yolisses/lispm/README.md

# LiSPM

_DIY low cost open source scanning probe microscope_

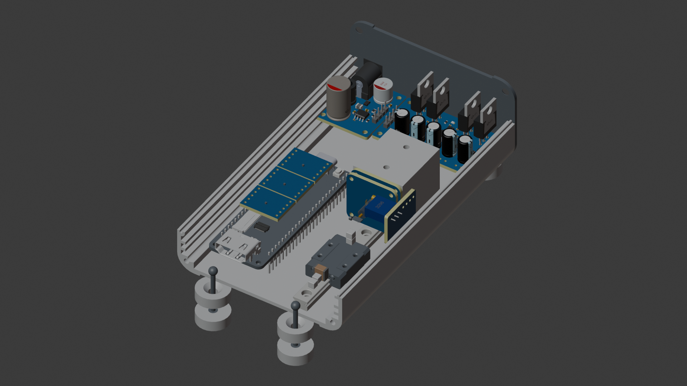
[picture p1: assets/3D Model.png]
3D model of the LiSPM


LiSPM aims to be a low cost scanning probe microscope (SPM), that works both as scanning tunneling microscope (STM) and atomic force microscope (AFM)

[More info on Docs](https://lispm.site)
