yolisses/lispm/Mechanics/README.md

# Piezo Support

The piezo support holds the scanning piezo disk aligned to the coarse actuator linear slider.

## Features

- Snap fit to the rail
- Screw holes to the rail
- Screw holes to the capacitive displacement sensor (CDS)
