yolisses/lispm/Electronics/README.md

# Electronics

The KiCAD projects here are just for simulation.

The printed circuit, passive parts selection and so on were moved to EasyEDA for closer integration with the manufacturer.
