yolisses/lispm/docs/index.md

---
title: LiSPM
layout: home
nav_order: 1
---

# LiSPM

3D model of the LiSPM

LiSPM is an open-source Scanning Probe Microscope (SPM). It can operate as a Scanning Tunneling Microscope (STM), an Atomic Force Microscope (AFM), or both simultaneously. It uses audio DACs and ADCs to reduce costs and achieve better precision than some previous works.
