yolisses/lispm/Documentation/content/Appendices/Resolution demo.md

# Resolution demo

Here are some images to give a sense of bandwidth:

## 250x250

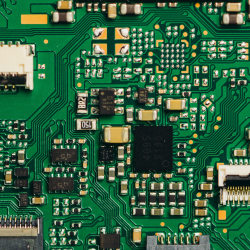
[picture p2: Documentation/static/resolution-demo-250x250.png]
Circuit on 250 by 250 pixels


## 500x500

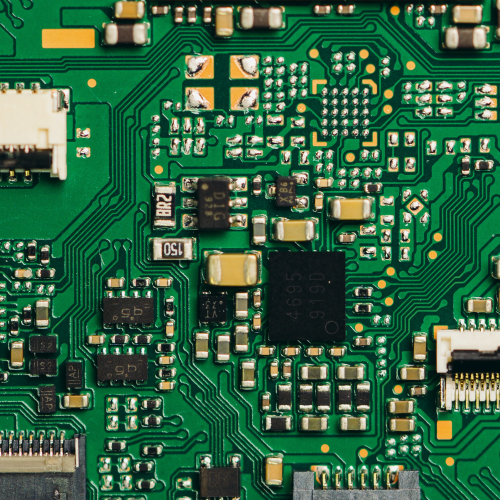
[picture p3: Documentation/static/resolution-demo-500x500.png]
Circuit on 500 by 500 pixels


## 1000x1000

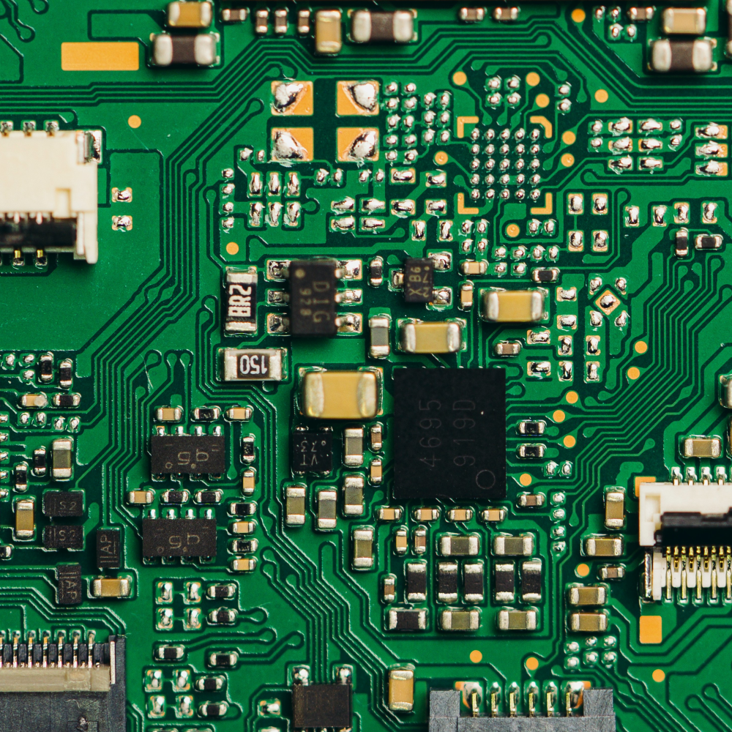
[picture p4: Documentation/static/resolution-demo-1000x1000.png]
Circuit on 1000 by 1000 pixels


## 1080x1080

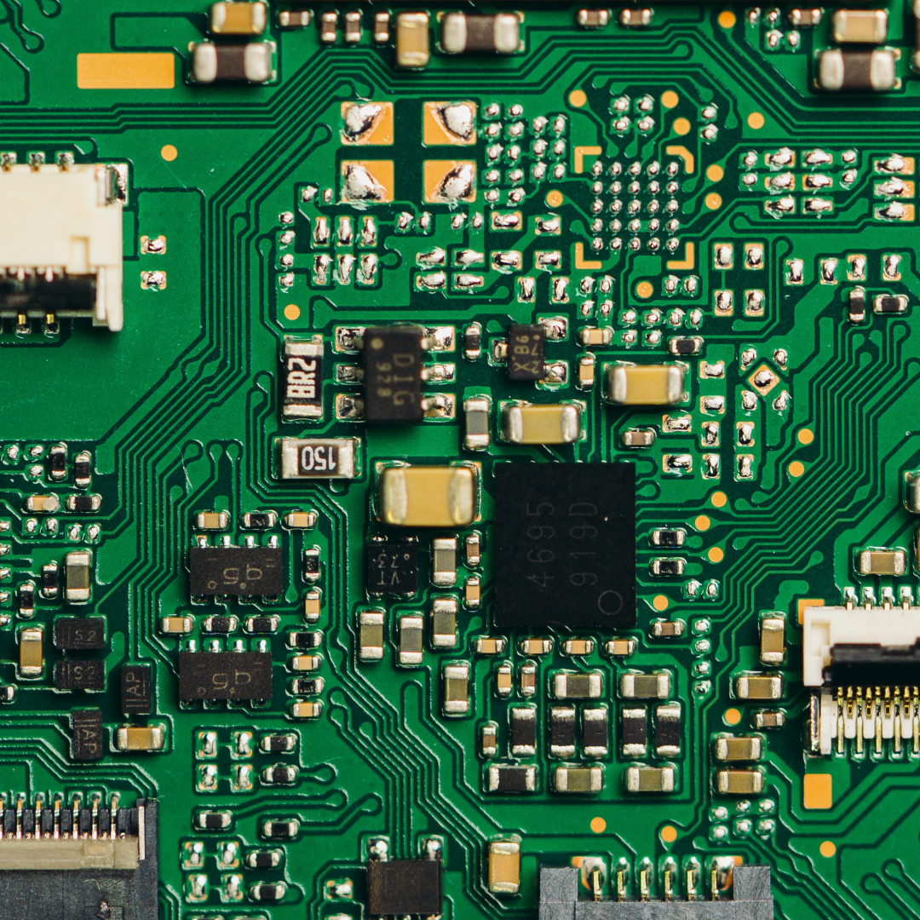
[picture p5: Documentation/static/resolution-demo-1080x1080.png]
Circuit on 1080 by 1080 pixels
