yolisses/lispm/Documentation/content/Appendices/Resolution comparison.md

# Resolution demo

Here are some images to give a sense of bandwidth:

TODO bring back the images from Google Docs.

## 250x250

Image of a circuit on 250 by 250 pixels

## 500x500

Image of a circuit on 500 by 500 pixels

## 1000x1000

Image of a circuit on 1000 by 1000 pixels

## 1080x1080

Image of a circuit on 1080 by 1080 pixels
