yolisses/lispm/Documentation/content/Methodology/Chronology.md

# Chronology

## [John Alexander's STM (2003)](https://john-alexander42.github.io/simple-stm-web-page/Project.htm)

The first STM using a piezo disk.  
It uses an external oscilloscope to display the output and an external function
generator to control the tip. Because of that, the microscope itself is
extremely cheap. But does not have some cool features like adjustable speeds,
bias, compensation. It does not have atomic precision.

## [STM Brasil (2010)](https://repositoriocopia.utfpr.edu.br/jspui/bitstream/1/8457/2/CT_ENGELN_2011_2_11.pdf)

Similar to the one from John Alexander, but even cheaper.

## [Dan Berard’s STM (2011)](https://dberard.com/home-built-stm/)

Has atomic resolution. Uses a digital control loop.

## [Vitor Barbosa's STM (2021)](https://www.researchgate.net/publication/354537056_Um_Microscopio_de_Varredura_por_Sonda_para_Aplicacoes_Sensiveis_ao_Custo)

Based on the Dan Berard’s STM and Dan Berard’s unfinished AFM.  
The STM has atomic resolution, and the AFM doesn’t seem to work.  
The circuits are separated in small modules.  
It has two versions, A and B. The B version is cheaper and achieves basically
the same functionality.  
It uses rechargeable lithium batteries to avoid noise from the power supply.

## [OpenSTM (2023)](<https://www.hardware-x.com/article/S2468-0672(23)00111-6/fulltext>)

Uses a linear slider. Has capacitive sensing to achieve fast coarse approach.

## [Mechanical Panda’s STM (2023)](https://github.com/MechRedPanda/red-panda-stm)

3D printed

## [Philip Turner's STM (2026)](https://github.com/philipturner/capacitive-displacement-metrology)
