yolisses/lispm/Documentation/content/Methodology/Price Comparison.md

# Price Comparison

To make sure we are getting the most bang for the buck, I created a
[price comparison table](https://docs.google.com/spreadsheets/d/1kJ4AdCbZYQlSQ2yOezcn3ApZPejCnOpOeinDMrVkBYM).
It lists the main parts (like ADC, DAC, coarse approach) for this and other DIY
SPM project. By now I didn't include AFMs, because they are so different from my
design that there's basically no comparison of parts.

Here's a preview. It may get too shrinked to fit in this page.

<div class="overflow-auto">
<iframe title="Price comparison spreadsheet preview" width="939" height="472" class="w-full" seamless frameborder="0" scrolling="yes" src="https://docs.google.com/spreadsheets/d/e/2PACX-1vQwseu9ZNBlsXy_UNZk5sbZHV0igHEu7i9kEx0DhHaTaEJR0XDxkKz2xaa8qJZoIBkbeAU8TqVDVuLU/pubchart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"></iframe>
</div>

Some things to keep in mind:

- Some projects are indicated with "Not all the parts". It may be because they
  are not publicly specified, the project is already too expensive to replicate,
  or just because I didn't bother searching enough.

- Some projects were made a long time ago, so the price of the components may
  have increased since them. Old parts get replaced in the market, becoming
  rarer.

- The graph alone makes the project of Philip Turner not seem as competitive,
  but he is going for a super advanced design with virtually no piezo
  distortions and compatible with ultra high vacuum. That may futurelly allow
  manufacturing at the nanoscale. It's very cool to
  [watch it unfold](https://x.com/philipturnerar), and it's extensively
  documented
  ([here](https://github.com/philipturner/capacitive-displacement-metrology) and
  [here](https://github.com/philipturner/transimpedance-amplifier)).
