yolisses/lispm/Documentation/content/Parts/Tip Standoff.md

# Tip Standoff

The standoff should be rigid and lightweight, so the motion of the piezo
translates nicely in the tip motion, and insulated, so the flow of the tip does
not leak elsewhere.  
Some solutions include:

- A Plastruct cylinder by
  [John Alexander](https://john-alexander42.github.io/simple-stm-web-page/disk_scanner.htm#:~:text=two%20pieces%20of%20%22-,Plastruct,-%22%20concentric%20plastic%20tubing)
- A custom aluminium support with sapphire disk as insulator, by
  [Dan Berard](https://dberard.com/home-built-stm/scan-head/#:~:text=drilled%20in%C2%A0an-,aluminum%20standoff,-.%20The%20standoff%20is)
- A fuse glass tube, by
  [Vitor Barbosa](https://www.researchgate.net/publication/354537056_Um_Microscopio_de_Varredura_por_Sonda_para_Aplicacoes_Sensiveis_ao_Custo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)
- A header pin on top of a glass piece, by
  [MechRedPanda](https://youtu.be/7N3OqTEq08g?si=07LbyEF9b0Th16Ux&t=190)
- A MMCX connector on a PCB, by
  [Dimsmary](https://www.bilibili.com/video/BV1Xi421Y7qa/?share_source=copy_web&t=405)
- A ceramic standoff, by [Jost Herkenhoff](https://github.com/jherkenhoff/STM)

The LiSPM uses a fuse glass tube. It’s cheap, light enough, rigid, easy to
reproduce, and one of the best insulators. It also allows easy integration with
the capacitive distance sensor due its regular radius and insulation across
length.  
To fix it in place, normal super glue is used.
