yolisses/lispm/Mechanics/Piezo Assembly.FCStd

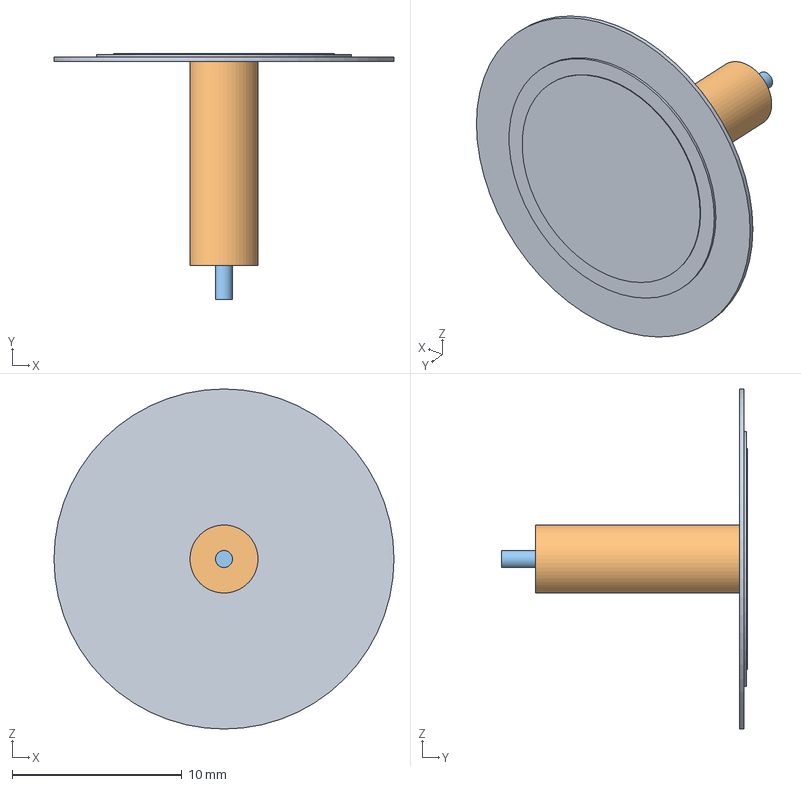
[picture p14: CAD file, 2026-08-11]
Mechanics/Piezo Assembly.FCStd
20.0 x 14.5 x 20.0 mm
Tip Holder
