yolisses/lispm/Electronics/AFM Oscillator/74HCU04D_653/74HCU04D_653.step

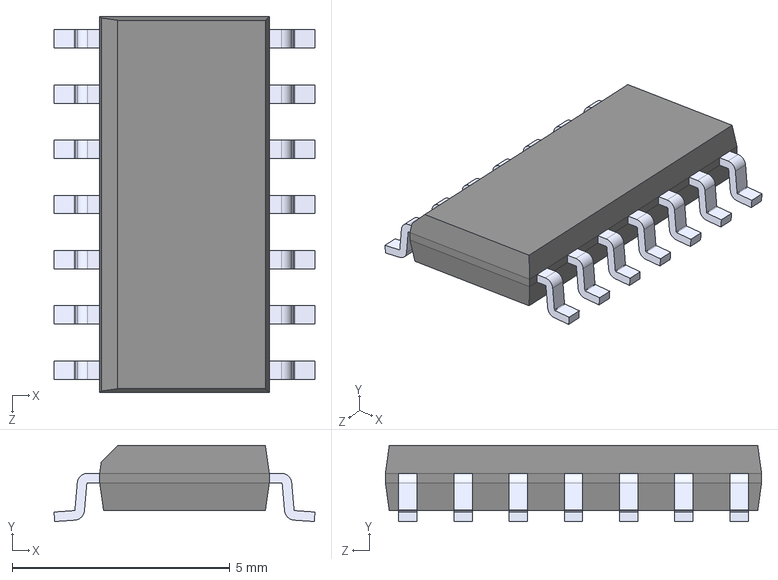
[picture p15: CAD file, 2026-06-24]
Electronics/AFM Oscillator/74HCU04D_653/74HCU04D_653.step
6.00 x 1.75 x 8.65 mm
