yolisses/lispm/Mechanics/PCB Feet.FCStd

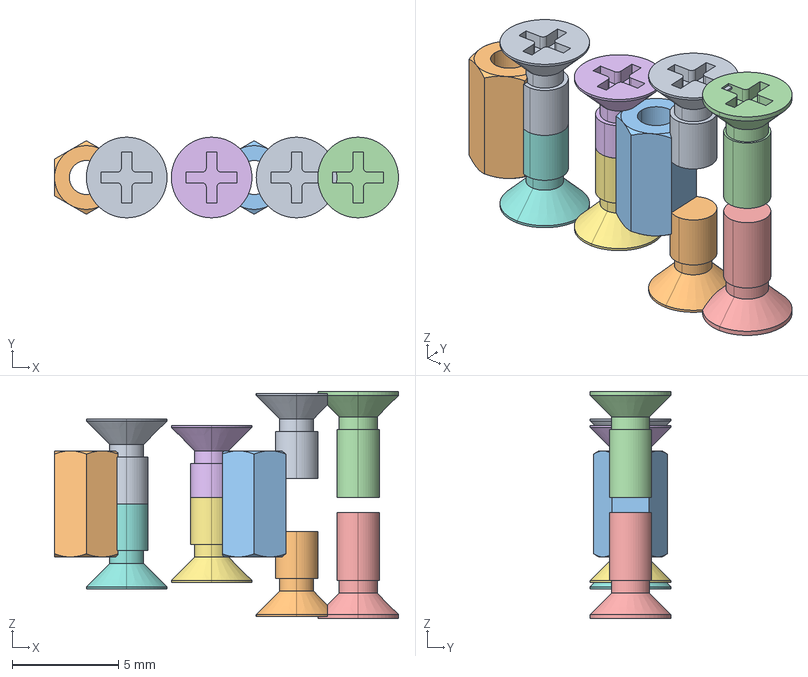
[picture p16: CAD file, 2026-10-21]
Mechanics/PCB Feet.FCStd
16.2 x 3.80 x 10.7 mm
EDLW-S1-M2-L4 003
EDLW-S1-M2-L4 004
EJLD-U3-M2-L002
EDLW-S1-M2-L5
EDLW-S1-M2-L001
EDLW-S1-M2-L4 005
EDLW-S1-M2-L4 006
EDLW-S1-M2-L4 007
EDLW-S1-M2-L4 008
EJLD-U3-M2-L003
