yolisses/lispm/Mechanics/LiSPM.FCStd

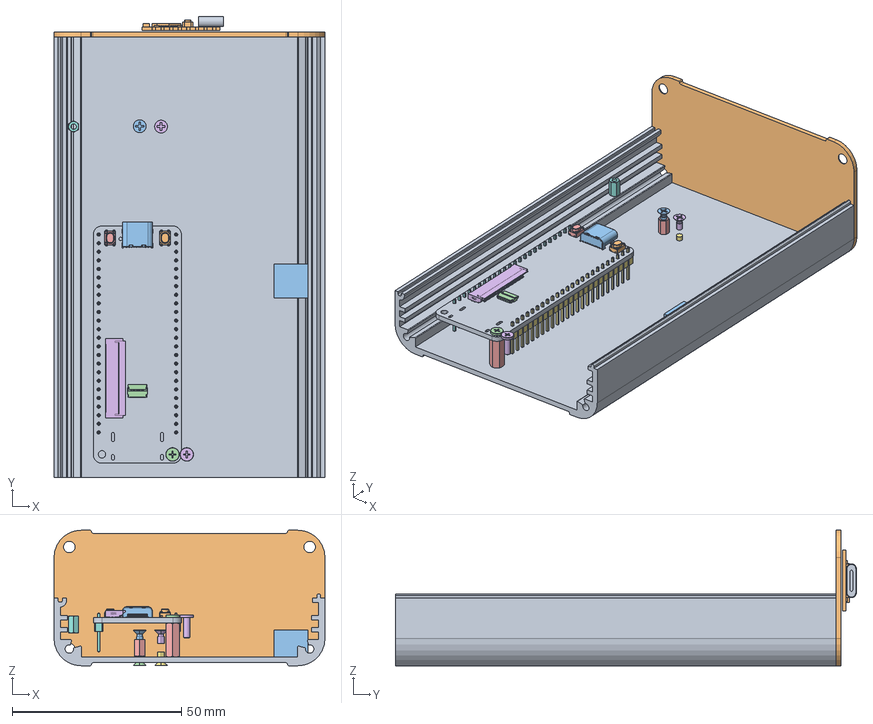
[picture p17: CAD file, 2026-10-21]
Mechanics/LiSPM.FCStd
80.0 x 136.1 x 40.0 mm
Box Bottom001
Box Rear001
EDLW-S1-M2-L4 001 x 2
EDLW-S1-M2-L4 002 x 2
EJLD-U3-M2-L001 x 2
EDLW-S1-M2-L4 003 x 2
EDLW-S1-M2-L4 004 x 2
EJLD-U3-M2-L002 x 2
Pcb_50f9
J1_User Library-USB-TYPE-C20_0000615593bd
P2_(\X2\672A4FDD5B58\X0\)_0000615a7746
J4_x05a20h40x v1_0000615be0a7
J6_PinHeader_1x24_P254mm_Vertical_00006155fc28
J5_PinHeader_1x24_P254mm_Vertical_000061561537
ESP32 C3 Super mini USB
ESP32 C3 Super mini board
ELSV-S1W-M2-L6-S4
EJLD-S3-M2-L10
ELSV-S1W-M2-L6-S001
