yolisses/lispm/Mechanics/Vibration Isolation Table.FCStd

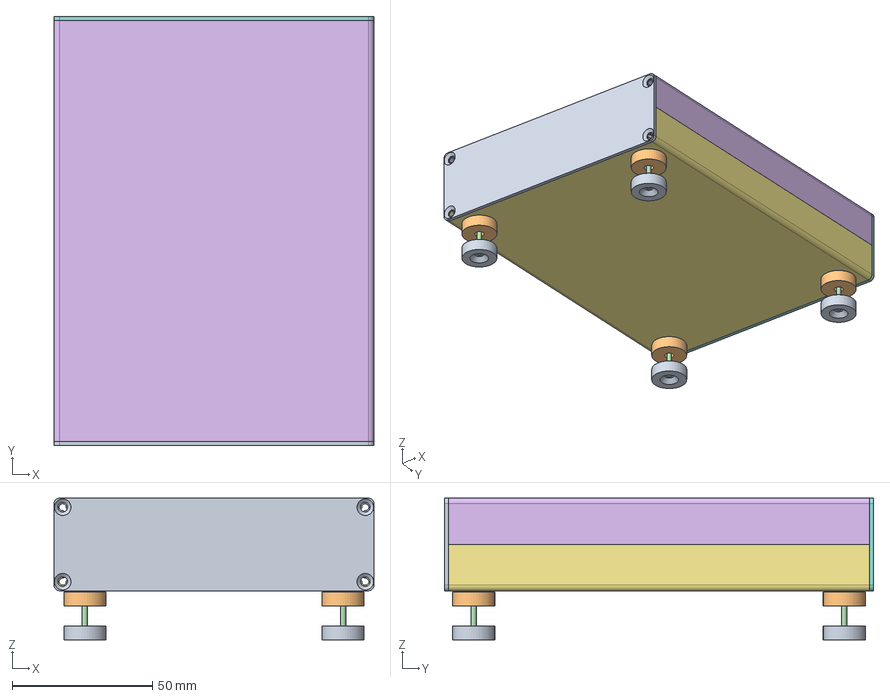
[picture p18: CAD file, 2026-10-21]
Mechanics/Vibration Isolation Table.FCStd
114.0 x 153.0 x 50.5 mm
