yolisses/lispm/Mechanics/Scan Head test 1.FCStd

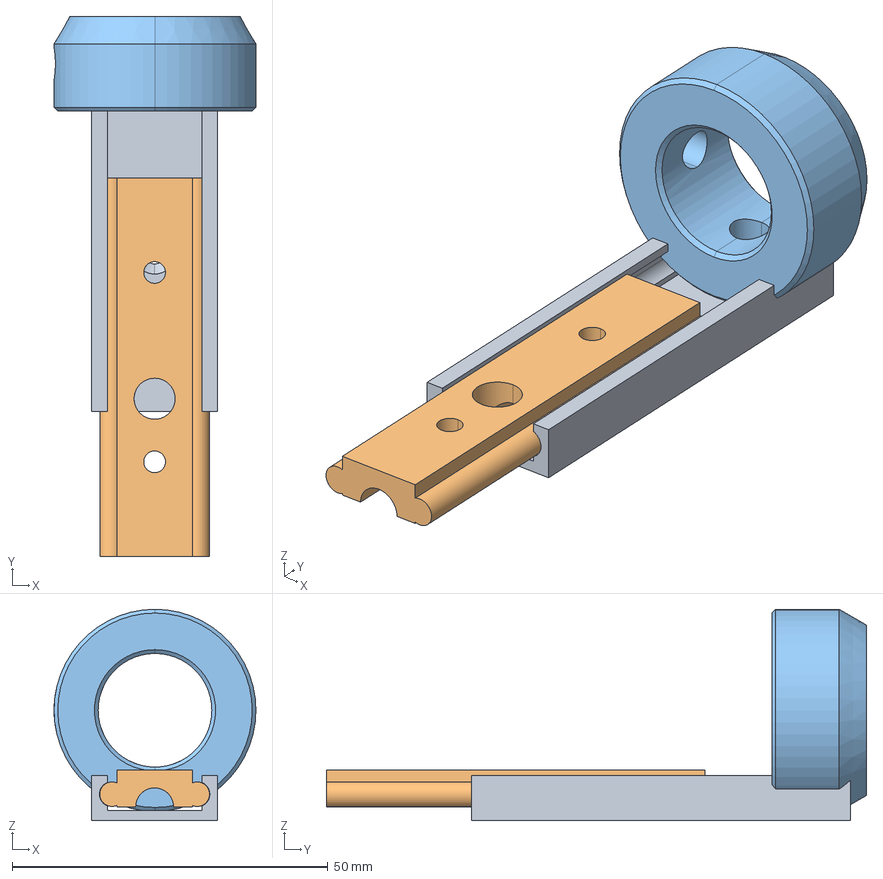
[picture p19: CAD file, 2026-10-21]
Mechanics/Scan Head test 1.FCStd
32.0 x 85.6 x 33.5 mm
1g^2082811826831597568
2g^2082811826831597568
FGDA-S1W-B-D18-T15
