yolisses/lispm/Mechanics/Scan Head MG73D.FCStd

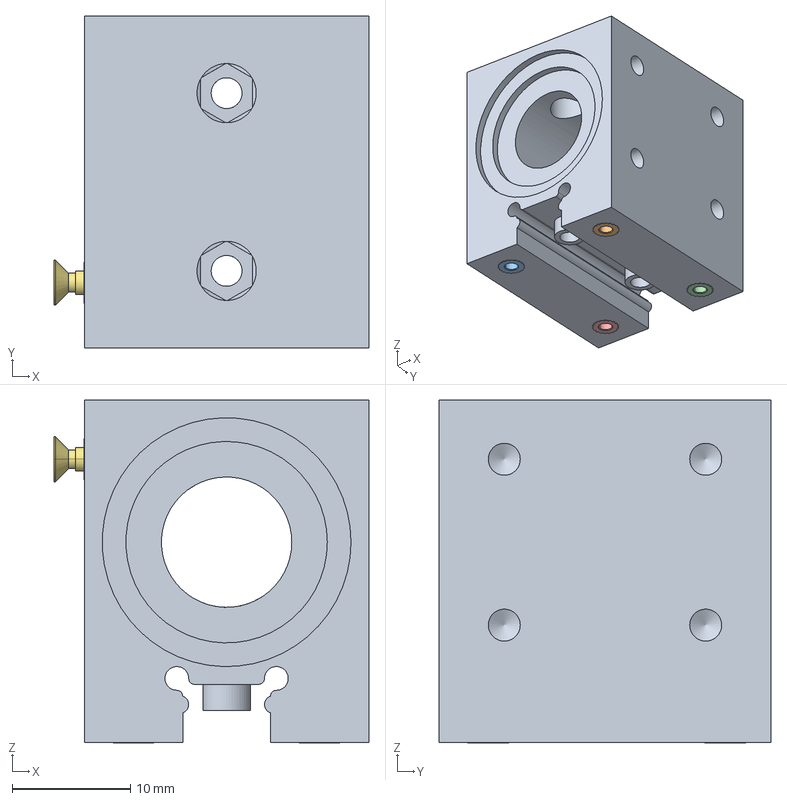
[picture p20: CAD file, 2026-08-15]
Mechanics/Scan Head MG73D.FCStd
26.6 x 28.0 x 29.0 mm
EMLZ-M2-L4 001 x 2
EMLZ-M2-L4 002 x 2
EMLZ-M2-L4 003 x 2
EMLZ-M2-L4 004 x 2
EMLZ-M2-L4 005 x 2
EDLW-S1-M2-L3
