yolisses/lispm/Mechanics/Scan Head.FCStd

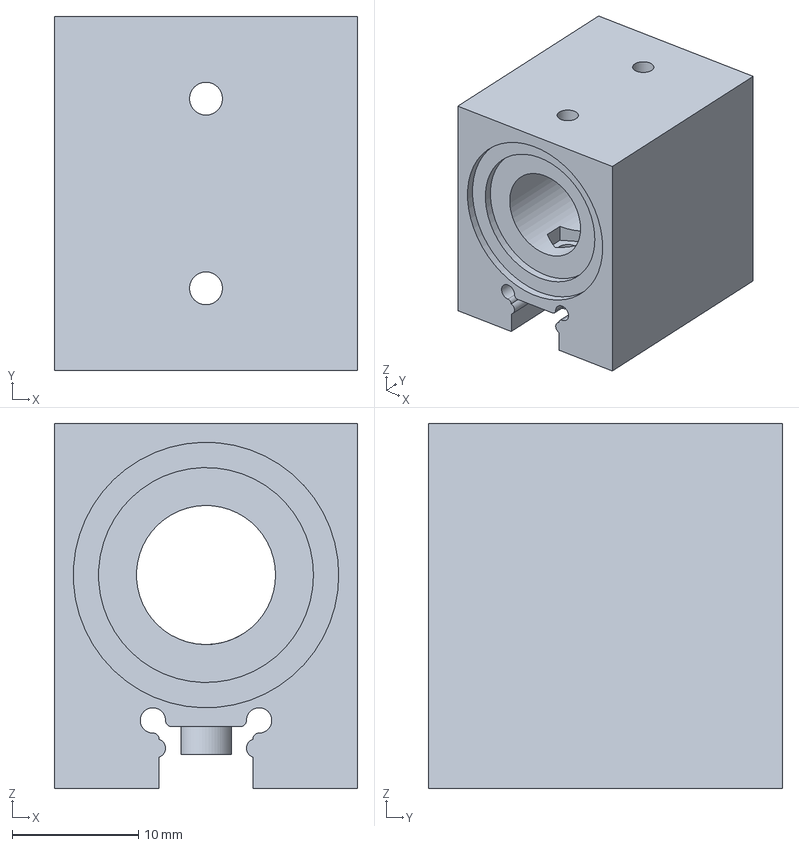
[picture p21: CAD file, 2026-08-12]
Mechanics/Scan Head.FCStd
24.0 x 28.0 x 28.9 mm
