yolisses/lispm/Mechanics/Aluminium Profile Scan Head.FCStd

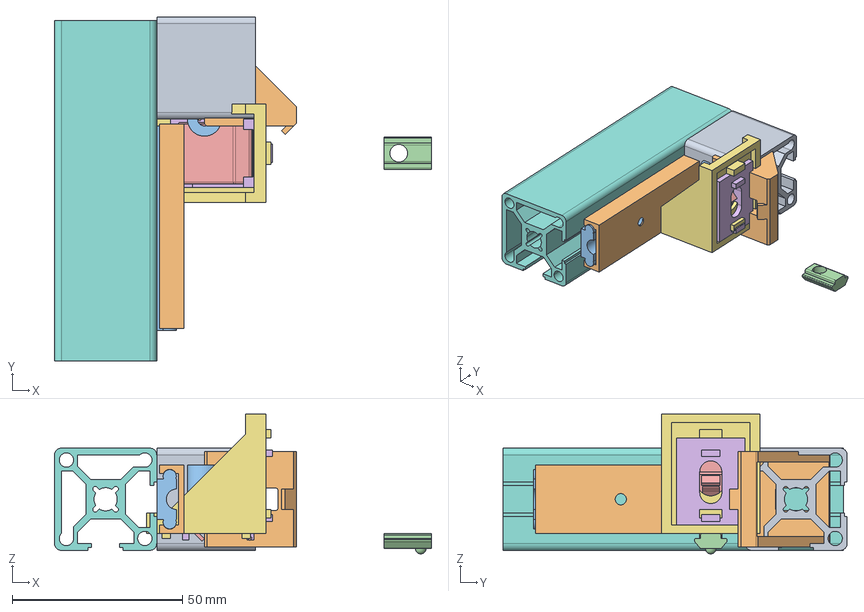
[picture p22: CAD file, 2026-08-12]
Mechanics/Aluminium Profile Scan Head.FCStd
110.6 x 101.0 x 41.0 mm
Piezo
1g^2082811826831597568
2g^2082811826831597568
TPAF-6-M6
TPEA-308-3030
TXCK-H6-3030B-L100
?? 1^2083053558563315712
Tube
