yolisses/lispm/Mechanics/Scan.FCStd

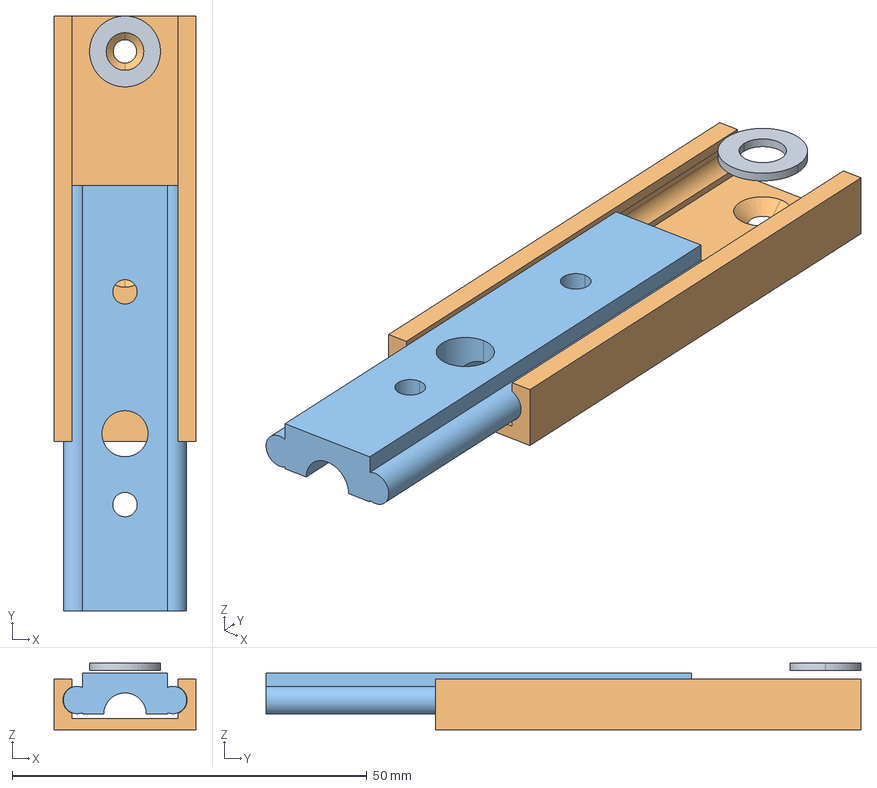
[picture p23: CAD file, 2026-08-12]
Mechanics/Scan.FCStd
20.0 x 83.9 x 9.40 mm
1g^2082811826831597568
2g^2082811826831597568
