yolisses/lispm/Mechanics/Coarse Approach.FCStd

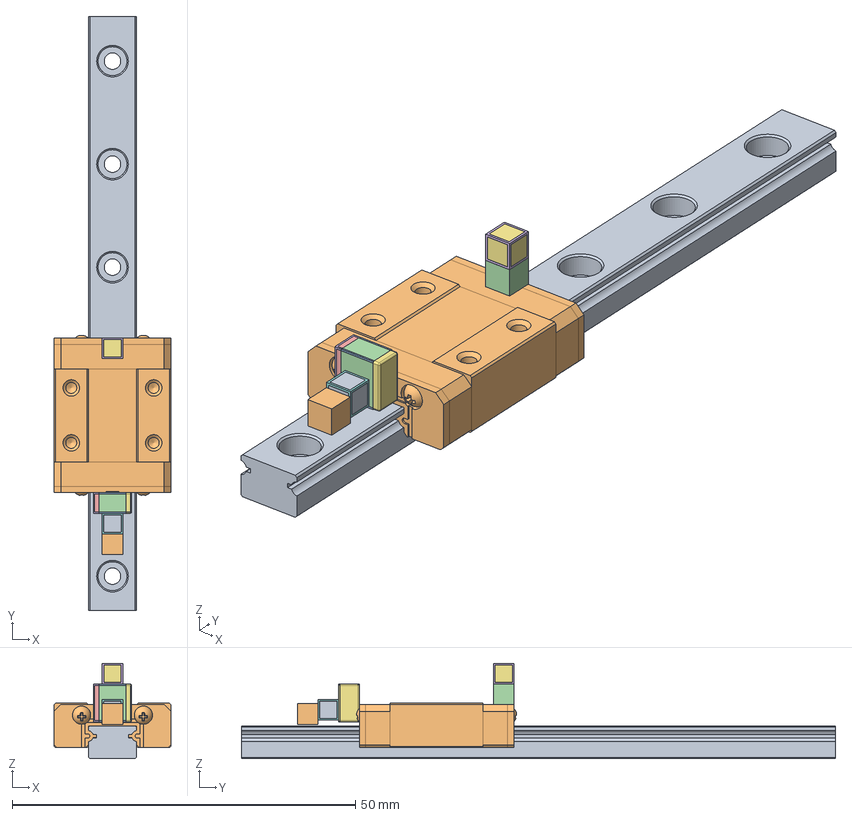
[picture p24: CAD file, 2026-08-12]
Mechanics/Coarse Approach.FCStd
17.0 x 86.5 x 13.9 mm
MGN7C_MGN7C
Ceramic
Lead001
Lead002
