yolisses/lispm/Mechanics/TIA T961P.FCStd

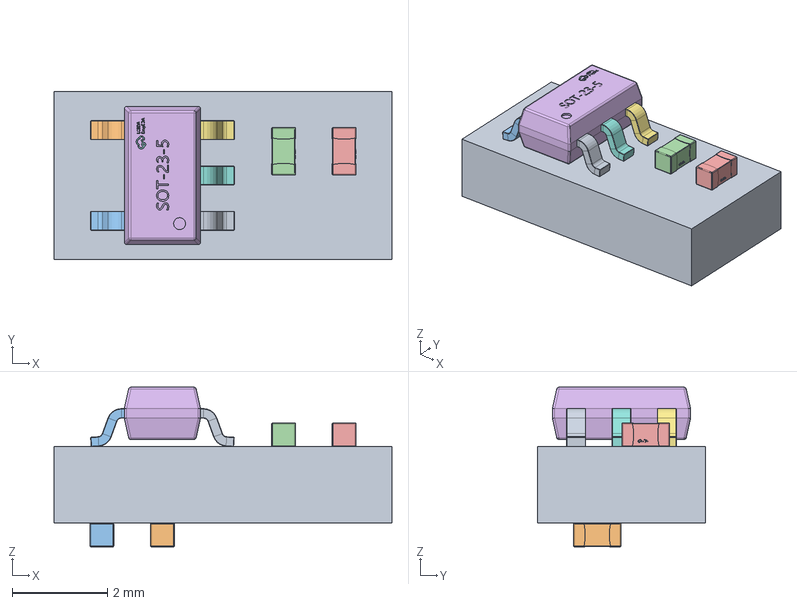
[picture p25: CAD file, 2026-08-12]
Mechanics/TIA T961P.FCStd
7.09 x 3.53 x 3.35 mm
Board~hpiH
C0402~C0402_L1.0-W0.5-H0.5~cPPC
C0402~C0402_L1.0-W0.5-H0.5~cPPC001
C0402~C0402_L1.0-W0.5-H0.5~cPPC002
C0402~C0402_L1.0-W0.5-H0.5~cPPC003
SOT-23-5_L3.0-W1.7-P0.95-LS2.8-BL~SOT-23-5_L2.9-W1.6-H1.1-LS2.8-P0.95~kJLz
SOT-23-5_L3.0-W1.7-P0.95-LS2.8-BL~SOT-23-5_L2.9-W1.6-H1.1-LS2.8-P0.95~kJLz001
SOT-23-5_L3.0-W1.7-P0.95-LS2.8-BL~SOT-23-5_L2.9-W1.6-H1.1-LS2.8-P0.95~kJLz002
SOT-23-5_L3.0-W1.7-P0.95-LS2.8-BL~SOT-23-5_L2.9-W1.6-H1.1-LS2.8-P0.95~kJLz003
SOT-23-5_L3.0-W1.7-P0.95-LS2.8-BL~SOT-23-5_L2.9-W1.6-H1.1-LS2.8-P0.95~kJLz004
SOT-23-5_L3.0-W1.7-P0.95-LS2.8-BL~SOT-23-5_L2.9-W1.6-H1.1-LS2.8-P0.95~kJLz005
SOT-23-5_L3.0-W1.7-P0.95-LS2.8-BL~SOT-23-5_L2.9-W1.6-H1.1-LS2.8-P0.95~kJLz006
SOT-23-5_L3.0-W1.7-P0.95-LS2.8-BL~SOT-23-5_L2.9-W1.6-H1.1-LS2.8-P0.95~kJLz007
SOT-23-5_L3.0-W1.7-P0.95-LS2.8-BL~SOT-23-5_L2.9-W1.6-H1.1-LS2.8-P0.95~kJLz008
SOT-23-5_L3.0-W1.7-P0.95-LS2.8-BL~SOT-23-5_L2.9-W1.6-H1.1-LS2.8-P0.95~kJLz009
SOT-23-5_L3.0-W1.7-P0.95-LS2.8-BL~SOT-23-5_L2.9-W1.6-H1.1-LS2.8-P0.95~kJLz010
SOT-23-5_L3.0-W1.7-P0.95-LS2.8-BL~SOT-23-5_L2.9-W1.6-H1.1-LS2.8-P0.95~kJLz011
SOT-23-5_L3.0-W1.7-P0.95-LS2.8-BL~SOT-23-5_L2.9-W1.6-H1.1-LS2.8-P0.95~kJLz012
SOT-23-5_L3.0-W1.7-P0.95-LS2.8-BL~SOT-23-5_L2.9-W1.6-H1.1-LS2.8-P0.95~kJLz013
SOT-23-5_L3.0-W1.7-P0.95-LS2.8-BL~SOT-23-5_L2.9-W1.6-H1.1-LS2.8-P0.95~kJLz014
SOT-23-5_L3.0-W1.7-P0.95-LS2.8-BL~SOT-23-5_L2.9-W1.6-H1.1-LS2.8-P0.95~kJLz015
SOT-23-5_L3.0-W1.7-P0.95-LS2.8-BL~SOT-23-5_L2.9-W1.6-H1.1-LS2.8-P0.95~kJLz016
SOT-23-5_L3.0-W1.7-P0.95-LS2.8-BL~SOT-23-5_L2.9-W1.6-H1.1-LS2.8-P0.95~kJLz017
SOT-23-5_L3.0-W1.7-P0.95-LS2.8-BL~SOT-23-5_L2.9-W1.6-H1.1-LS2.8-P0.95~kJLz018
