yolisses/lispm/Mechanics/Shallow Aluminium Profile.FCStd

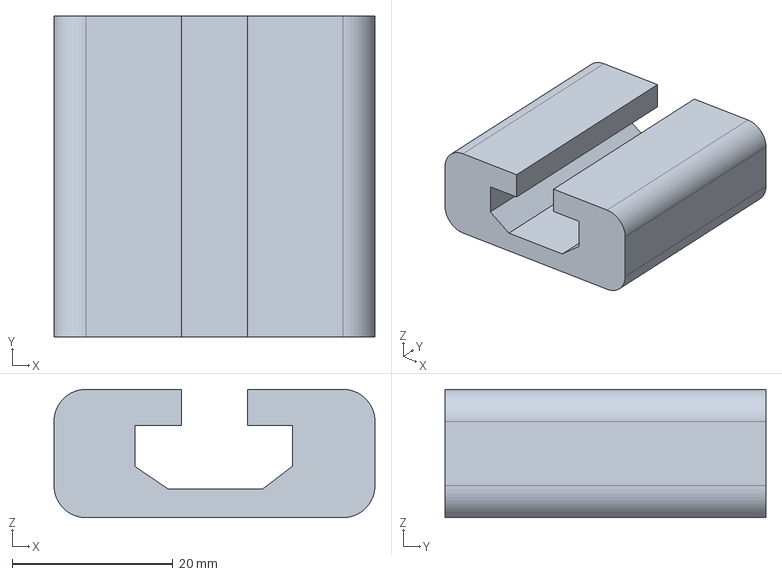
[picture p28: CAD file, 2026-08-11]
Mechanics/Shallow Aluminium Profile.FCStd
40.0 x 40.0 x 16.0 mm
