yolisses/lispm/Mechanics/PSU Inverter.FCStd

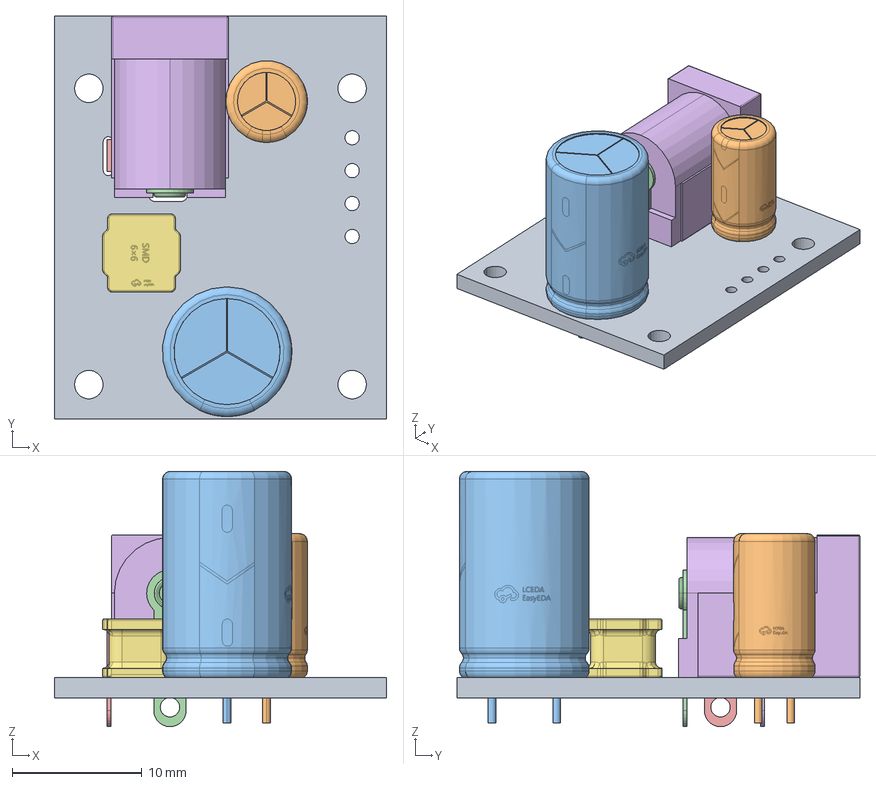
[picture p29: CAD file, 2026-08-11]
Mechanics/PSU Inverter.FCStd
25.6 x 31.1 x 19.7 mm
Board~VOIn
CAP-TH_BD6.3-P2.50-D1.0-FD~CAP-TH_BD6.3-P2.50-D1.0-FD~OW5m
CAP-TH_BD10.0-P5.00-D1.0-FD~CAP-TH_D10.0-H16.0-P5.00~Dgic
DC-IN-TH_DC-005-5.5-2.0~DC-IN-TH_DC-5520-1~a1Dk
DC-IN-TH_DC-005-5.5-2.0~DC-IN-TH_DC-5520-1~a1Dk001
DC-IN-TH_DC-005-5.5-2.0~DC-IN-TH_DC-5520-1~a1Dk002
IND-SMD_L6.0-W6.0~IND-SMD_L6.0-W6.0-H4.5~MMMF
