yolisses/lispm/Mechanics/Regulators Board.FCStd

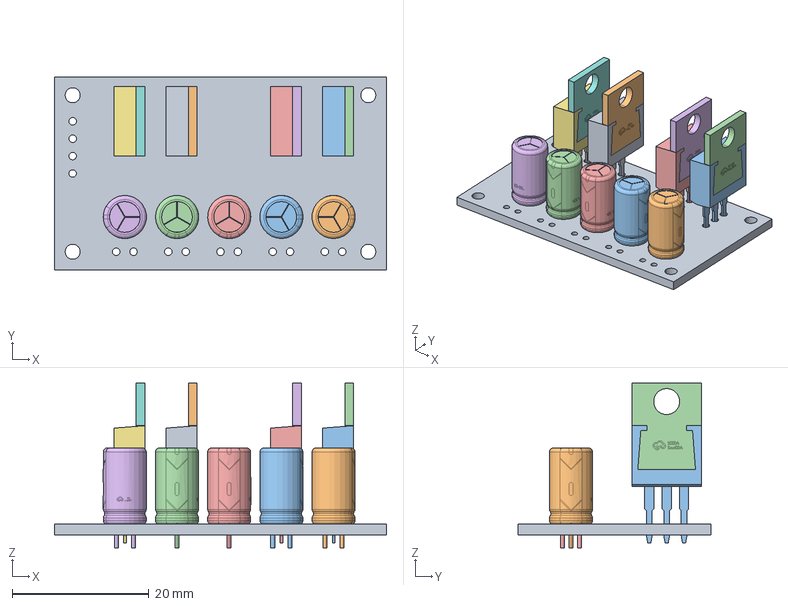
[picture p30: CAD file, 2026-08-11]
Mechanics/Regulators Board.FCStd
48.5 x 28.2 x 24.1 mm
Board~EvKF
CAP-TH_BD6.3-P2.50-D1.0-FD~CAP-TH_BD6.3-P2.50-D1.0-FD~p0XM
CAP-TH_BD6.3-P2.50-D1.0-FD~CAP-TH_BD6.3-P2.50-D1.0-FD~p0XM001
CAP-TH_BD6.3-P2.50-D1.0-FD~CAP-TH_BD6.3-P2.50-D1.0-FD~p0XM002
CAP-TH_BD6.3-P2.50-D1.0-FD~CAP-TH_BD6.3-P2.50-D1.0-FD~p0XM003
CAP-TH_BD6.3-P2.50-D1.0-FD~CAP-TH_BD6.3-P2.50-D1.0-FD~p0XM004
TO-220-3_L10.0-W4.5-P2.54-T~TO-220-3_L10.0-W4.5-P2.54-L~BOaM
TO-220-3_L10.0-W4.5-P2.54-T~TO-220-3_L10.0-W4.5-P2.54-L~BOaM001
TO-220-3_L10.0-W4.5-P2.54-T~TO-220-3_L10.0-W4.5-P2.54-L~BOaM003
TO-220-3_L10.0-W4.5-P2.54-T~TO-220-3_L10.0-W4.5-P2.54-L~BOaM004
TO-220-3_L10.0-W4.5-P2.54-T~TO-220-3_L10.0-W4.5-P2.54-L~BOaM006
TO-220-3_L10.0-W4.5-P2.54-T~TO-220-3_L10.0-W4.5-P2.54-L~BOaM007
TO-220-3_L10.0-W4.5-P2.54-T~TO-220-3_L10.0-W4.5-P2.54-L~BOaM009
TO-220-3_L10.0-W4.5-P2.54-T~TO-220-3_L10.0-W4.5-P2.54-L~BOaM010
