yolisses/lispm/Mechanics/Mag Lev Leg.FCStd

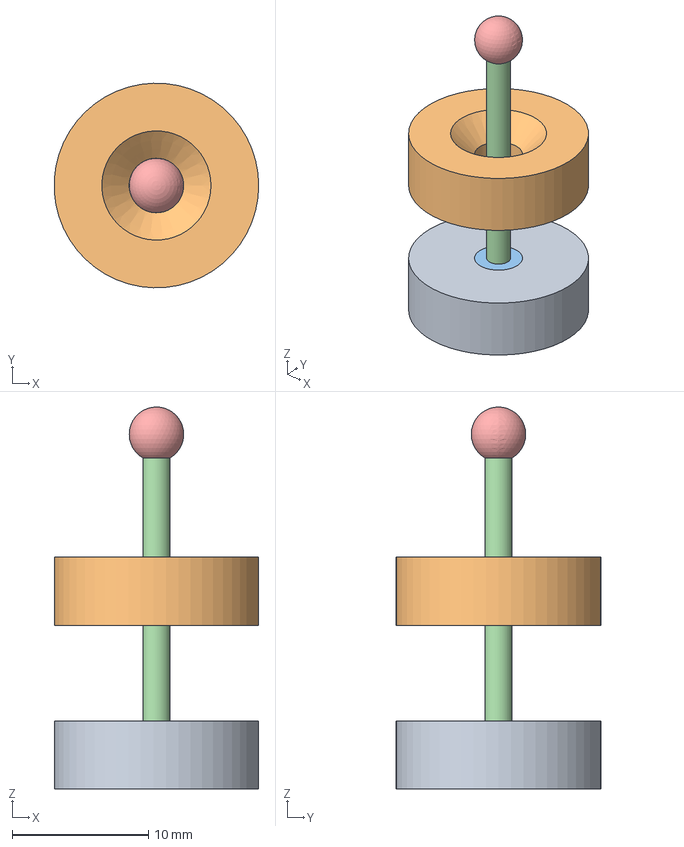
[picture p31: CAD file, 2026-08-11]
Mechanics/Mag Lev Leg.FCStd
15.0 x 15.0 x 28.0 mm
