yolisses/lispm/Mechanics/AFM Probe.FCStd

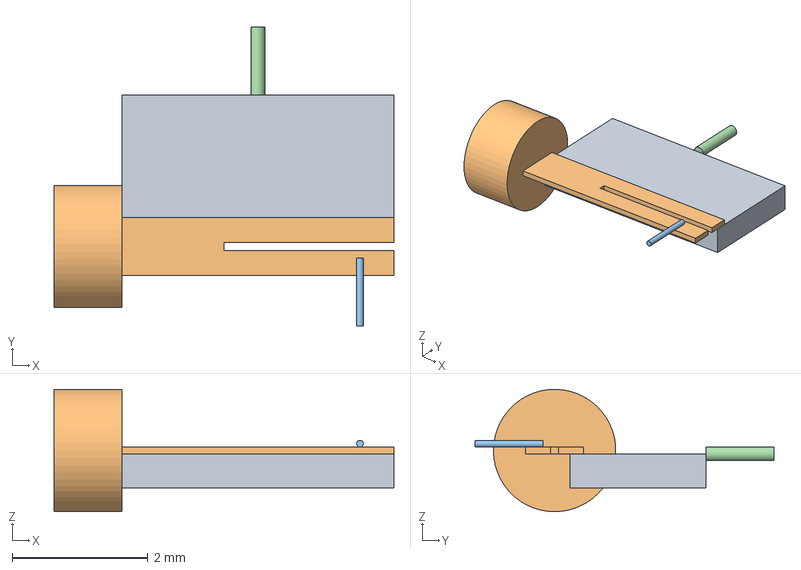
[picture p32: CAD file, 2026-07-31]
Mechanics/AFM Probe.FCStd
5.00 x 4.40 x 1.80 mm
QTF Support
Tip
