yolisses/lispm/Mechanics/QTF.FCStd

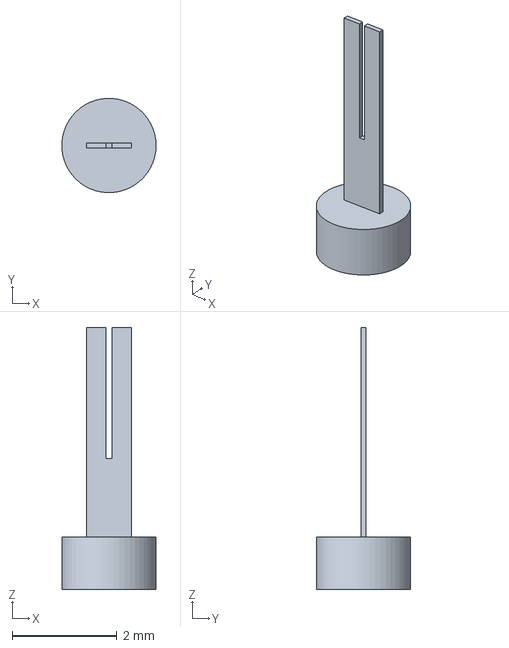
[picture p33: CAD file, 2026-07-31]
Mechanics/QTF.FCStd
1.80 x 1.80 x 5.00 mm
