yolisses/lispm/Mechanics/Piezo support.FCStd

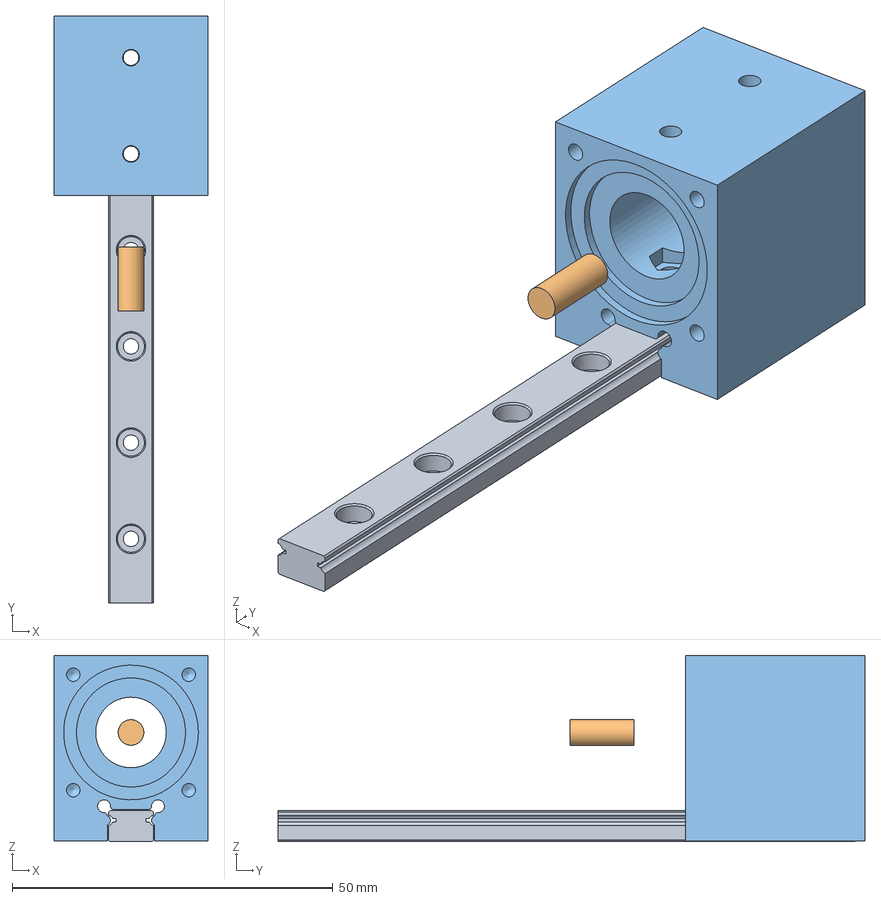
[picture p35: CAD file, 2026-06-22]
Mechanics/Piezo support.FCStd
24.0 x 91.5 x 29.0 mm
