yolisses/lispm/Mechanics/Piezo support shaft support.FCStd

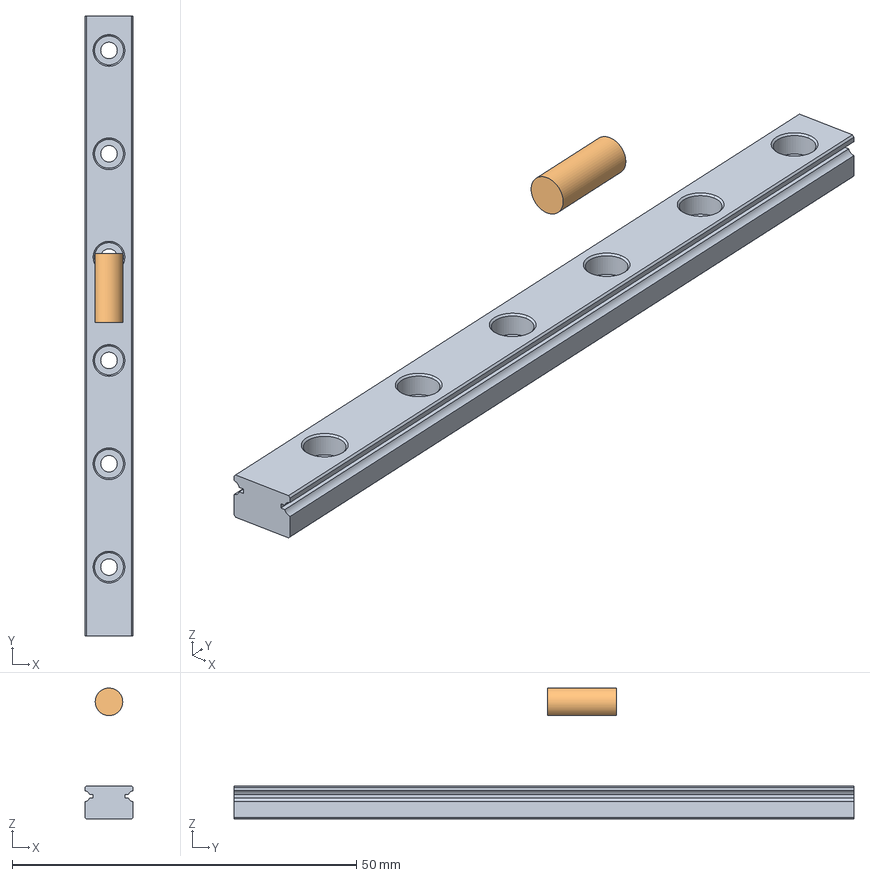
[picture p36: CAD file, 2026-06-22]
Mechanics/Piezo support shaft support.FCStd
7.00 x 90.0 x 19.0 mm
