yolisses/lispm/Mechanics/Piezo electrostatic.FCStd

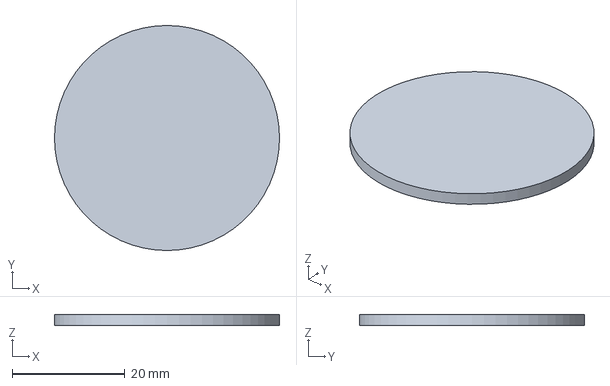
[picture p37: CAD file, 2026-05-25]
Mechanics/Piezo electrostatic.FCStd
40.0 x 40.0 x 2.00 mm
