yolisses/lispm/Mechanics/Capacitance example.FCStd

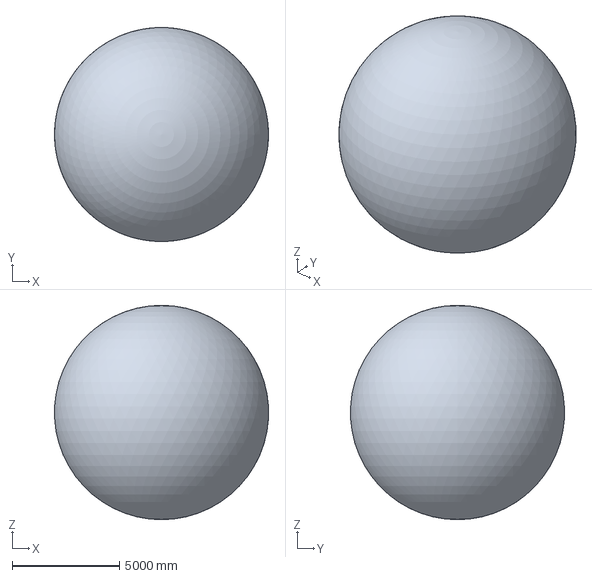
[picture p38: CAD file, 2026-05-25]
Mechanics/Capacitance example.FCStd
9983.1 x 9983.1 x 10000.0 mm
