yolisses/lispm/Mechanics/Piezo support-Cut.step

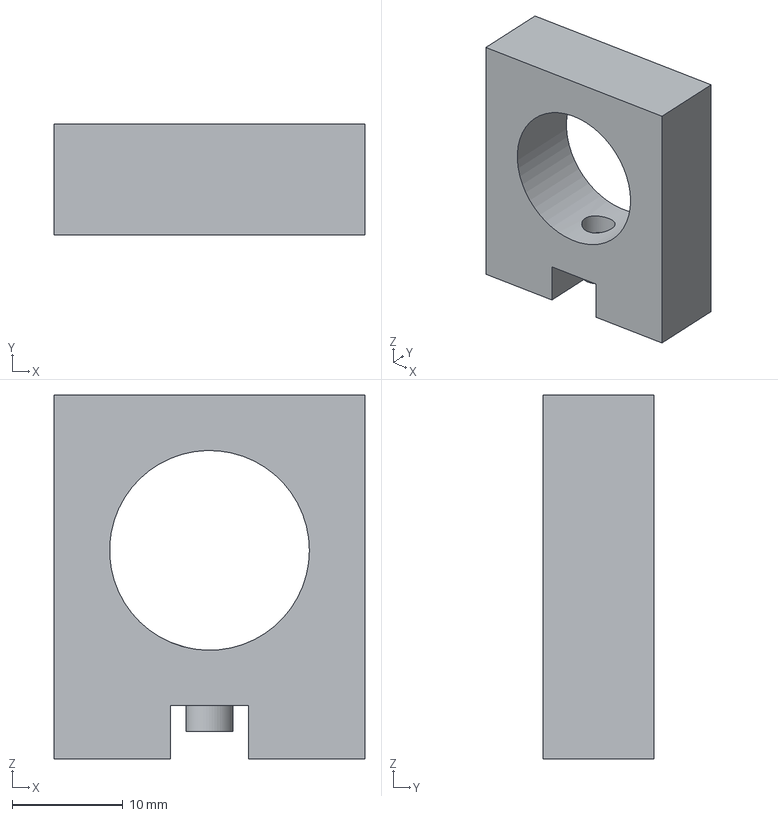
[picture p39: CAD file, 2026-04-03]
Mechanics/Piezo support-Cut.step
28.0 x 10.0 x 32.8 mm
