yolisses/lispm/Mechanics/Piezo support-Piezo Support.step

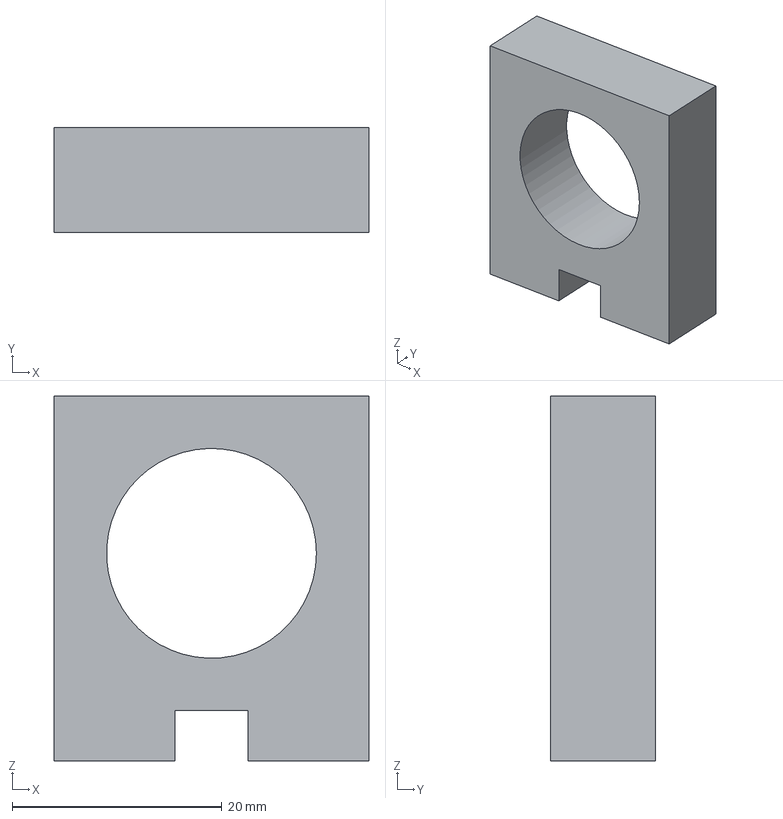
[picture p40: CAD file, 2026-04-03]
Mechanics/Piezo support-Piezo Support.step
30.0 x 10.0 x 34.8 mm
