yolisses/lispm/Mechanics/Piezo support 1.FCStd

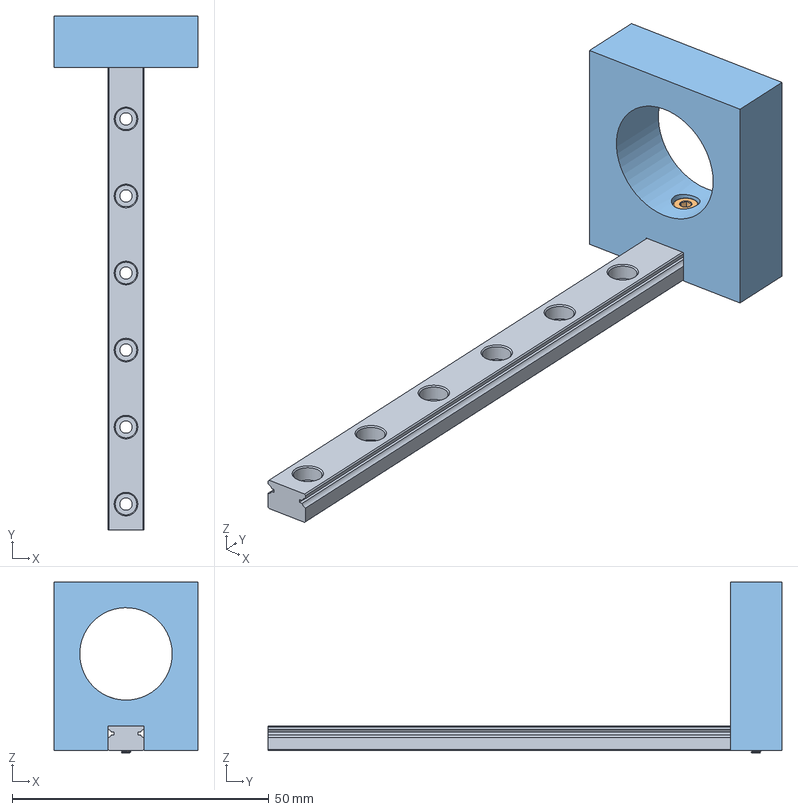
[picture p41: CAD file, 2026-04-03]
Mechanics/Piezo support 1.FCStd
28.0 x 100.0 x 33.3 mm
MGN7 rail_100 mm
M2x8-Screw
