yolisses/lispm/(list of files, cad)

Other CAD files:
Mechanics/Scan MG73D.FCStd
Electronics/PSU/LMR16030SDDA/LMR16030SDDA.step
Mechanics/Piezo Support.stl
