yolisses/lispm/Documentation/content/Parts/Math testing.md

# Math testing

Inline $x+1$

$$
\frac{1}{2}
$$

test

Lift($$L$$) can be determined by Lift Coefficient ($$C_L$$) like the following
equation.

$$
L = \frac{1}{2} \rho v^2 S C_L
$$
