yolisses/lispm/Firmware/todo.txt

Find out the required pins for setting the DAC value.
Creating the scan loop
Check if it makes sense to use the same clock signal for all DAC's.
Initialize the DAC
Set the power on sequence
Set range
Create the coarse approach code
Finish the main board schematics
Design the TIA and ADC board
Create the user interface
