yolisses/lispm/(list of files, drawings)

Other design files:
Electronics/TIA/OPA858/opa858.dsn
Electronics/TIA/OPA858/opa858.opj
Electronics/TIA/TLV906x/tlv9062.dsn
Electronics/TIA/TLV906x/tlv9062.opj
