yolisses/lispm/(commit log)

2026-03-05 Try creating the SPI entry point
2026-03-12 Add voltage refference in README
2026-03-12 Add mechanical CAD file
2026-04-03 Update the FreeCAD file
    [Piezo support-Cut.step, Piezo support-Piezo Support.step, Piezo support.FCStd]
2026-05-02 Update the mechanical files
    [Piezo support-Cut.step, Piezo support-Piezo Support.step, Piezo support.FCStd]
2026-05-11 Create TIA simulation, with a simple capacitor charging simulation
    [TIA.kicad_pcb, TIA.kicad_sch]
2026-05-11 Create demo frequency response in the TIA simulation KiCad project
    [TIA.kicad_sch]
2026-05-11 Break the simulation somehow
    [TIA.kicad_sch]
2026-05-11 Fix TIA simulation
    [TIA.kicad_pcb, TIA.kicad_sch]
2026-05-11 Replace voltage source by current source
    [TIA.kicad_sch]
2026-05-16 Create example of tuned TIA with simulation
    [Single Amplifier.kicad_sch, TIA.kicad_sch, Two Amplifiers.kicad_sch, old.kicad_sch, two_amplifiers.kicad_sch]
2026-05-18 Create a robust TIA design following the requirements
    [OPA858.kicad_sch, OPA859 1G.kicad_sch, OPA859.kicad_sch, Single Amplifier.kicad_sch, TIA.kicad_pcb, TIA.kicad_sch, Two Amplifiers.kicad_sch, old.kicad_sch]
2026-05-18 Make the simulation circuit tidier
    [OPA859.kicad_sch, TIA.kicad_sch]
2026-05-18 Remove unnecessary backups
    [OPA858.kicad_sch, Single Amplifier.kicad_sch, TIA.kicad_pcb, TIA.kicad_sch, Two Amplifiers.kicad_sch, old.kicad_sch, two_amplifiers.kicad_sch]
2026-05-18 Remove some files
    [OPA859.kicad_sch, old.kicad_sch, two_amplifiers.kicad_sch]
2026-05-19 Create simpler stability simulation
    [Just resistor.kicad_sch, OPA858 Complex.kicad_sch, OPA858.kicad_sch, Stability.kicad_pcb, Stability.kicad_sch]
2026-05-19 Create resistor + capacitor simulation
    [Resistor and capacitor.kicad_sch, Stability.kicad_sch]
2026-05-19 Create stability compensation simulation
    [Resistor and capacitor.kicad_sch, Stability compensation.kicad_sch, Stability.kicad_sch]
2026-05-20 Create ULCA simulation
    [ULCA.kicad_pcb, ULCA.kicad_sch, Voltage output.kicad_sch]
2026-05-20 Add OPA858 stability simulation
    [Realitisic.kicad_sch, Stability compensation.kicad_sch, Stability.kicad_sch]
2026-05-20 Create simulation of ULCA with parasitic capacitances
    [Parasitic capacitance.kicad_sch, ULCA.kicad_sch]
2026-05-20 Achieve good specifications under unrealistic conditions for the ULCA
    [Tunning.kicad_sch, ULCA.kicad_sch]
2026-05-20 Create an okayish tunned ULCA
    [Different topology.kicad_sch, ULCA.kicad_sch, plot.csv]
2026-05-20 Implement the peculiar equivalent schematics from OPA380
    [OPA380.DSN, OPA380.OLB, OPA380.opj, Peculiar.kicad_pcb, Peculiar.kicad_sch]
2026-05-21 Create the peculiar transimpedance amplifier
    [From OPA380.kicad_sch, Nested simple.kicad_sch, Nested.kicad_sch, Peculiar.kicad_sch]
2026-05-22 Improve the peculiar TIA
    [Bode plot.csv, OPA858.kicad_sch, Peculiar.kicad_sch, TRAN_TB.dsn, de_sim.cfg, opa695.dsn, opa858.dsn, opa858.opj]
2026-05-22 Add LMC606 to simulation
    [LMC606.kicad_sch, LMC606x.OLB, LMC606x_Test_Circuit.DSN, LMC606x_Test_Circuit.OPJ, Peculiar.kicad_sch]
2026-05-22 Create some other simulations
    [3 Op Amps.kicad_sch, LMC606.kicad_sch, Peculiar.kicad_sch, Three Op Amps.kicad_sch]
2026-05-22 Separate two and three OPA858 designs
    [OPA161x.OLB, OPA161x_Test_Circuit.DSN, OPA161x_Test_Circuit.OPJ, OPA858.kicad_sch, Three Op Amps.kicad_sch]
2026-05-22 Create a great design using OPA858 and OPA162
    [From OPA380.kicad_sch, LMC606.kicad_sch, Nested simple.kicad_sch, Nested.kicad_sch, OPA858 and OPA162.kicad_sch, Peculiar.kicad_sch, Three Op Amps.kicad_sch]
2026-05-22 Mess around with the values in the TIA simulation (I found out some)
    [OPA858 and OPA162.kicad_sch]
2026-05-23 Remove old simulations
    [3 Op Amps.kicad_sch, Bode plot.csv, Different topology.kicad_sch, From OPA380.kicad_sch, Just resistor.kicad_sch, LMC606.kicad_sch, LMC606x.OLB, LMC606x_Test_Circuit.DSN]
2026-05-25 Mess around with the simulation
    [Capacitance example.FCStd, OPA858 Stage.kicad_sch, OPA858.kicad_sch, Piezo electrostatic.FCStd, Power supply.kicad_sch, opa858.dsn, opa858.opj]
2026-05-25 Create simulation for RS8751
    [OPA858 Stage.kicad_sch, RS8751.kicad_sch, TIA.kicad_sch]
2026-05-27 Add ESP32 C3 on the CAD
2026-05-27 Mess around with the TIA simulation
    [OPA858 Stage.kicad_sch, RS8751.kicad_sch]
2026-05-27 Update TIA board 3D model
2026-05-27 Change TIA board position
2026-05-27 Add driver boards
2026-05-27 Add sample model
2026-06-02 Create Pi filter simulation
    [Pi filter.kicad_pcb, Pi filter.kicad_sch]
2026-06-02 Create PSU simulation
    [LMR16030SDDA.step, PSU.kicad_pcb, PSU.kicad_sch]
2026-06-02 Experiment fitting the regulators board with smaller capacitors
2026-06-03 Create decoupling capacitors simulation
    [Decoupling capacitors.kicad_pcb, Decoupling capacitors.kicad_sch]
2026-06-03 Organize decoupling capacitors simulation
    [Decoupling capacitors.kicad_sch]
2026-06-05 Replace "LiSTM" by "LiSPM" accross files
    [spi.v]
2026-06-08 Create switching capacitors simulation
    [Switching capacitors.kicad_pcb, Switching capacitors.kicad_sch]
2026-06-10 Improve logo visibility on the CAD model
2026-06-10 Add ADC board model
2026-06-10 Remove small components from CAD model
2026-06-10 Remove old PSU board
2026-06-12 Start optimizating the PSU for space
    [PSU.kicad_sch]
2026-06-19 Create a better piezo support model
    [Piezo support 1.FCStd, Piezo support.FCStd]
2026-06-19 Test different power filter tradeoffs
    [Pi filter.kicad_sch]
2026-06-19 Add markings on the piezo support
    [Piezo support.FCStd]
2026-06-20 Add extra screw holes on the piezo support
    [Piezo support.FCStd]
2026-06-20 Remove part markings, since they complicate the fabrication
    [Piezo support.FCStd]
2026-06-22 Refine the 3D model for the piezo support
    [Piezo support shaft support.FCStd, Piezo support.FCStd]
2026-06-22 Make the piezo support parametric
    [Piezo support.FCStd]
2026-06-22 Add parametric round corners to the round corner of the piezo support
    [Piezo support.FCStd]
2026-06-22 Update the piezo support on LiSPM.FCStd and refactor assemble positions
    [Piezo support.FCStd]
2026-06-24 Create AFM oscillator simulation
    [74HCU04D_653.step, AFM Oscillator.kicad_pcb, AFM Oscillator.kicad_sch]
2026-07-02 Add IC choice on ADC documentation
2026-07-06 Create the FreeCAD project for the CPS
    [Capacitive Position Sensor.FCStd, LiSPM.FCStd]
2026-07-15 Play with TIA simulation
    [RS8751.kicad_sch]
2026-07-15 Implement in memory theme switch
2026-07-19 Experiment with EasyEDA FreeCAD extension
    [LiSPM.FCStd, TIA.FCStd]
2026-07-31 rename the standoff page to tip standoff
2026-07-31 Separate AFM Probe
    [AFM Probe.FCStd, LiSPM.FCStd, QTF.FCStd]
2026-07-31 Remove capacitive sensor from older versions
    [AFM Probe.FCStd, LiSPM.FCStd]
2026-08-04 Experiment with different aluminium profiles as piezo standoff
    [Aluminium Profile Scan Head.FCStd, LiSPM.FCStd, Scan Head.FCStd]
2026-08-09 Create simulation of level shifter
    [Level shifter.kicad_pcb, Level shifter.kicad_sch]
2026-08-09 Simulate a 1G TIA gain again
    [OPA858 Stage.kicad_sch, RS8751.kicad_sch]
2026-08-09 Add search and theme buttons on mobile
2026-08-10 Experiment with stabilizing capacitor
    [RS8751.kicad_sch]
2026-08-10 Add note about the TIA op amp footprints
2026-08-11 Separate mag lev leg in a new file
    [LiSPM.FCStd, Mag Lev Leg.FCStd]
2026-08-11 Update regulators board
    [LiSPM.FCStd, Regulators Board.FCStd]
2026-08-11 Update PSU Inverter 3D model
    [LiSPM.FCStd, PSU Inverter.FCStd]
2026-08-11 Add PCB standoffs to 3D model
    [LiSPM.FCStd]
2026-08-11 Organize power supply models
    [LiSPM.FCStd]
2026-08-11 Improve the PSU standoff models
    [LiSPM.FCStd]
2026-08-11 Separate Piezo Assembly
    [LiSPM.FCStd, Piezo Assembly.FCStd, Scan Head.FCStd, Shallow Aluminium Profile.FCStd]
2026-08-11 Update the TIA R874B to fit better
    [LiSPM.FCStd, Scan Head.FCStd, TIA R874B.FCStd]
2026-08-12 Add the TIA T961N 3D model
    [LiSPM.FCStd, Scan Head.FCStd, TIA T961N.FCStd]
2026-08-12 Add the TIA T961P 3D model
    [LiSPM.FCStd, Scan Head.FCStd, TIA T961P.FCStd]
2026-08-12 Start organizing variations into separate files
    [Aluminium Profile Scan Head.FCStd, Coarse Approach.FCStd, LiSPM.FCStd, Scan Head MG73D.FCStd, Scan Head.FCStd, Scan MG73D.FCStd, Scan.FCStd]
2026-08-12 Add heat nuts in the MG73D model
    [Scan Head MG73D.FCStd]
2026-08-12 Adjust the top to bottom screw holes in the Scan Head MG73D
    [Scan Head MG73D.FCStd]
2026-08-12 Play with the TLV9061 simulation
    [TIA.kicad_sch, TLV906.kicad_sch]
2026-08-15 Simulate regulator
    [Regulator.kicad_pcb, Regulator.kicad_sch]
2026-08-15 Update the scan head model
    [LiSPM.FCStd, Scan Head MG73D.FCStd]
2026-09-25 Display the search and theme buttons easier on mobile
2026-10-01 Test more realistic decoupling capacitor values
    [Decoupling capacitors.kicad_sch]
2026-10-22 Create previous and next page buttons
2026-10-22 Fix next page button text for index pages
2026-10-22 Improve the GitHub button
2026-10-22 Color the current page in the navbar
